varmagokul6/Quadcopter-With-Autonomous-Payload/SolidWorks_Drawings.pdf

B | B

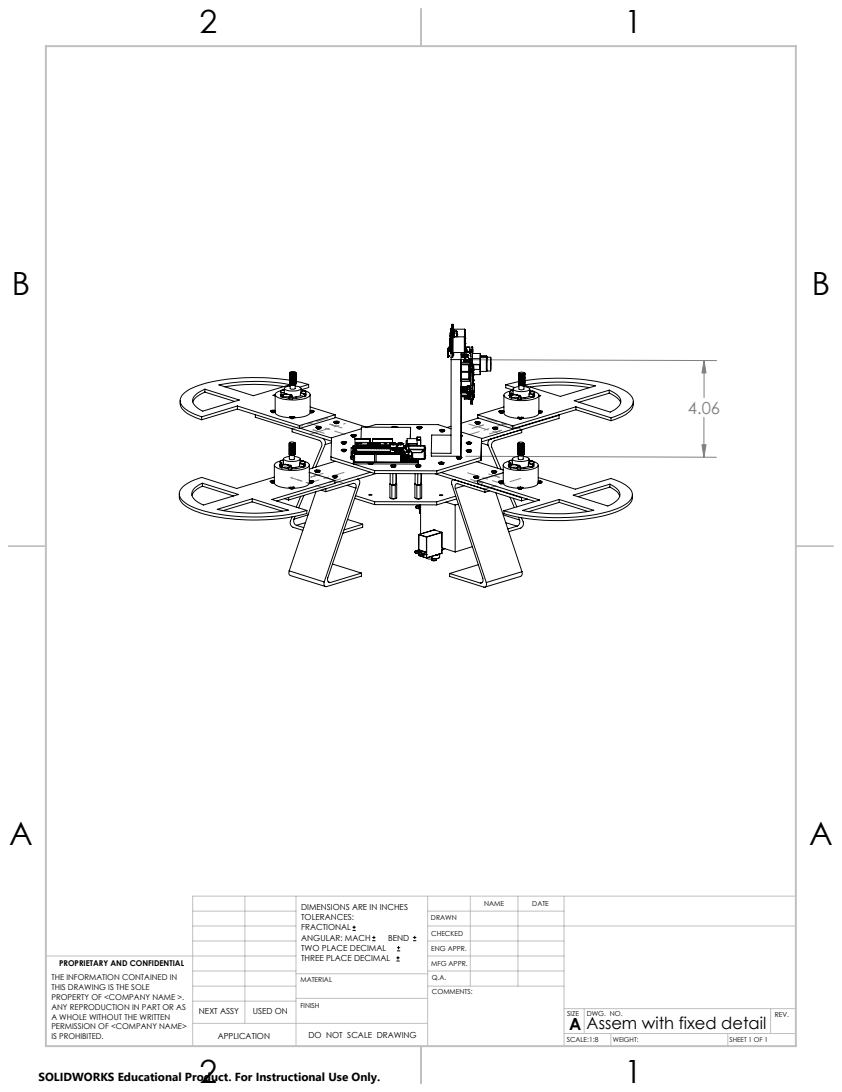
[picture p15: page 1]
COMMENTS:

TOLERANCES: FRACTIONAL ANGULAR: MACH BEND TWO PLACE DECIMAL THREE PLACE DECIMAL | | NAME | DATE DIMENSIONS ARE IN INCHES

DRAWN
CHECKED
ENG APPR.

PROPRIETARY AND CONFIDENTIAL THE INFORMATION CONTAINED IN THIS DRAWING IS THE SOLE PROPERTY OF <COMPANY NAME >. ANY REPRODUCTION IN PART OR AS A WHOLE WITHOUT THE WRITTEN PERMISSION OF <COMPANY NAME> IS PROHIBITED. | | | MFG APPR.

MATERIAL | Q.A.

NEXT ASSY | USED ON | FINISH

SIZE A | DWG. NO. Assem with fixed detail | REV.

APPLICATION | | DO NOT SCALE DRAWING

SCALE:1:8 | WEIGHT: | SHEET 1 OF 1

SOLIDWORKS Educational Product. For Instructional Use Only.

B | B

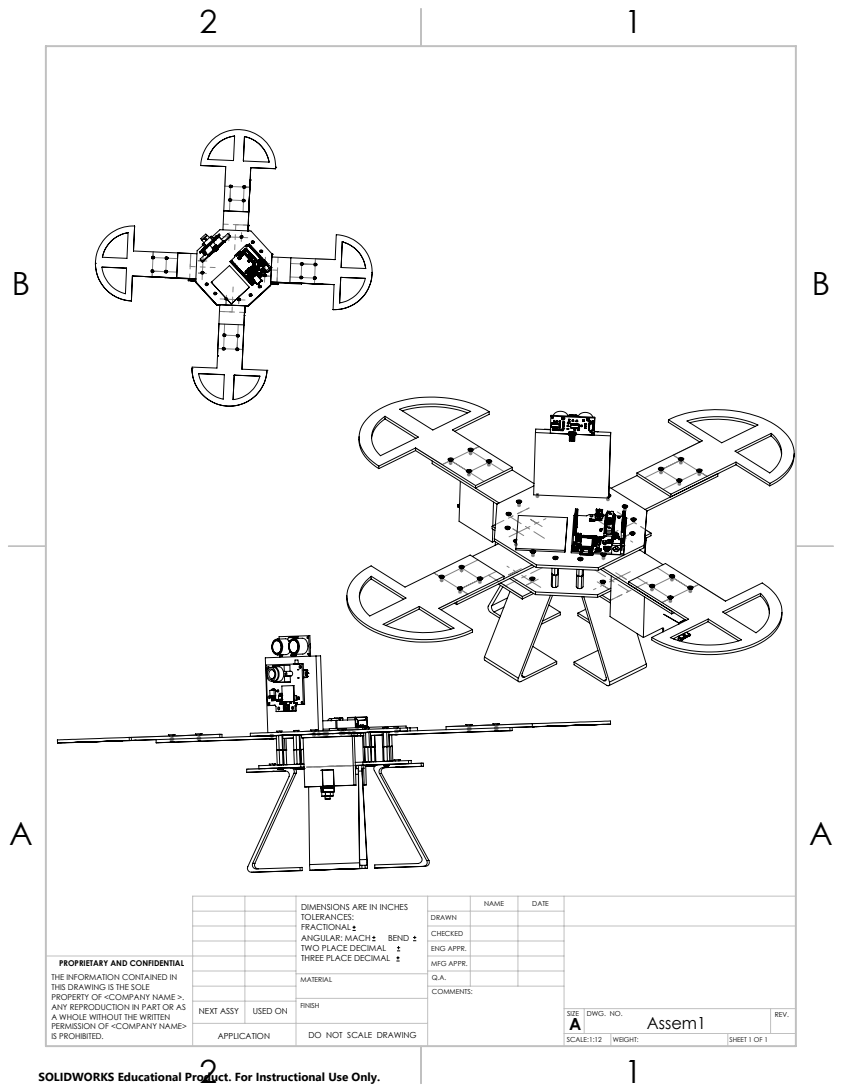
[picture p16: page 2]
Assem1; COMMENTS:

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

DRAWN
CHECKED
ENG APPR.

PROPRIETARY AND CONFIDENTIAL THE INFORMATION CONTAINED IN THIS DRAWING IS THE SOLE PROPERTY OF <COMPANY NAME >. | | | MFG APPR.

MATERIAL | Q.A.

B | B

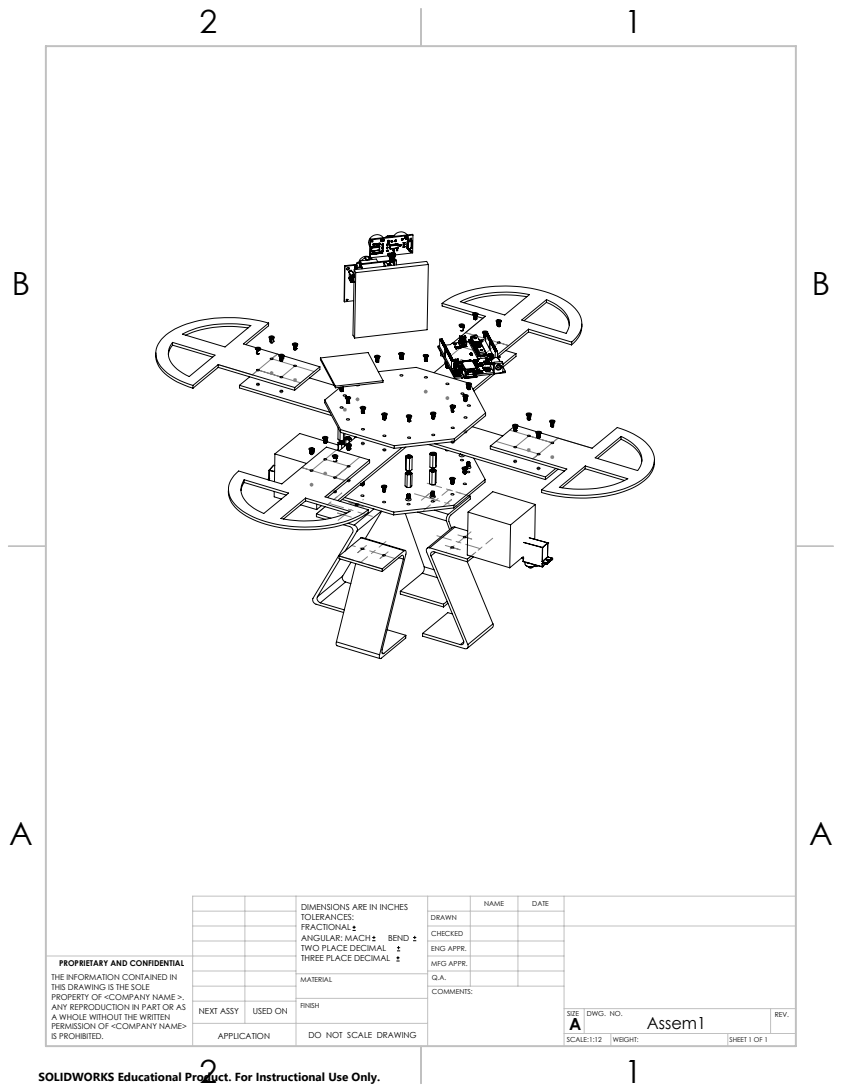
[picture p17: page 3]
Assem1; COMMENTS:

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

DRAWN
CHECKED
ENG APPR.

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

MATERIAL | Q.A.

2.49
B | B

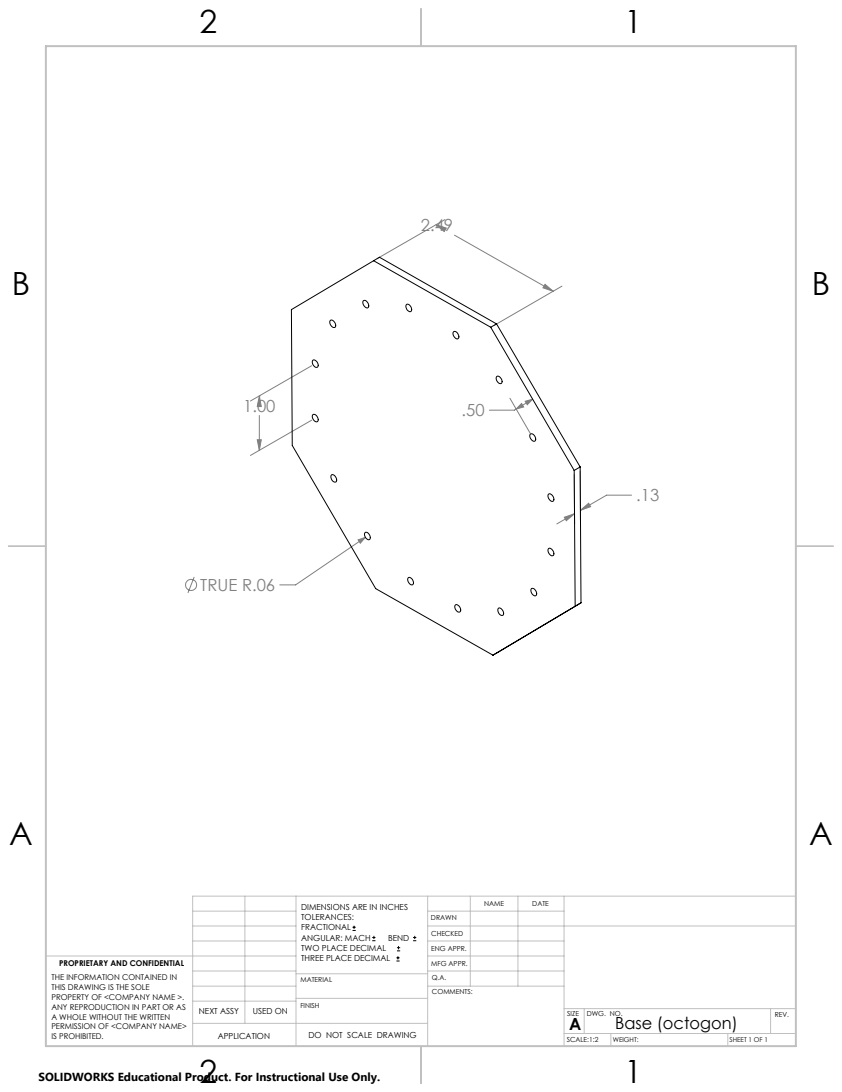
[picture p18: page 4]
TRUE R.06; Base (octogon); COMMENTS:

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

DRAWN
CHECKED
ENG APPR.

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

MATERIAL | Q.A.

B | B

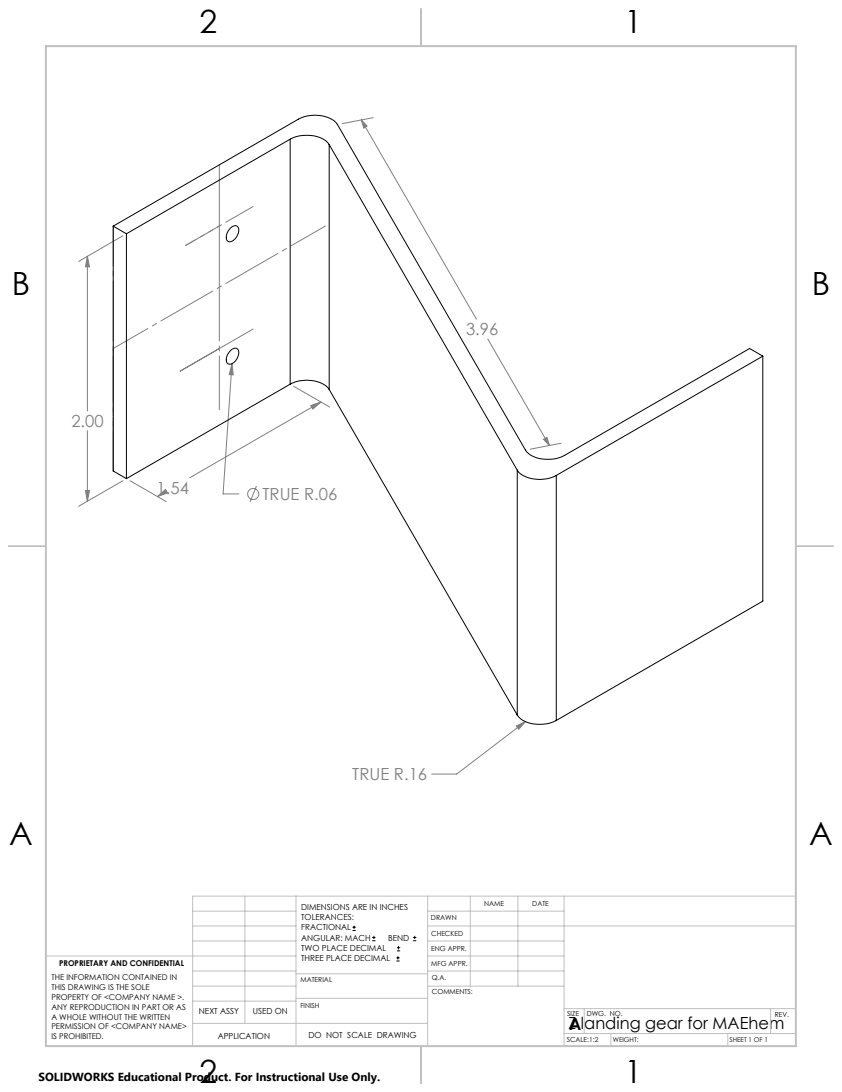
[picture p19: page 5]
TRUE R.06; TRUE R.16; COMMENTS:

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

DRAWN
CHECKED
ENG APPR.

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

MATERIAL | Q.A.

Z landing gear for MAEhem

B | B

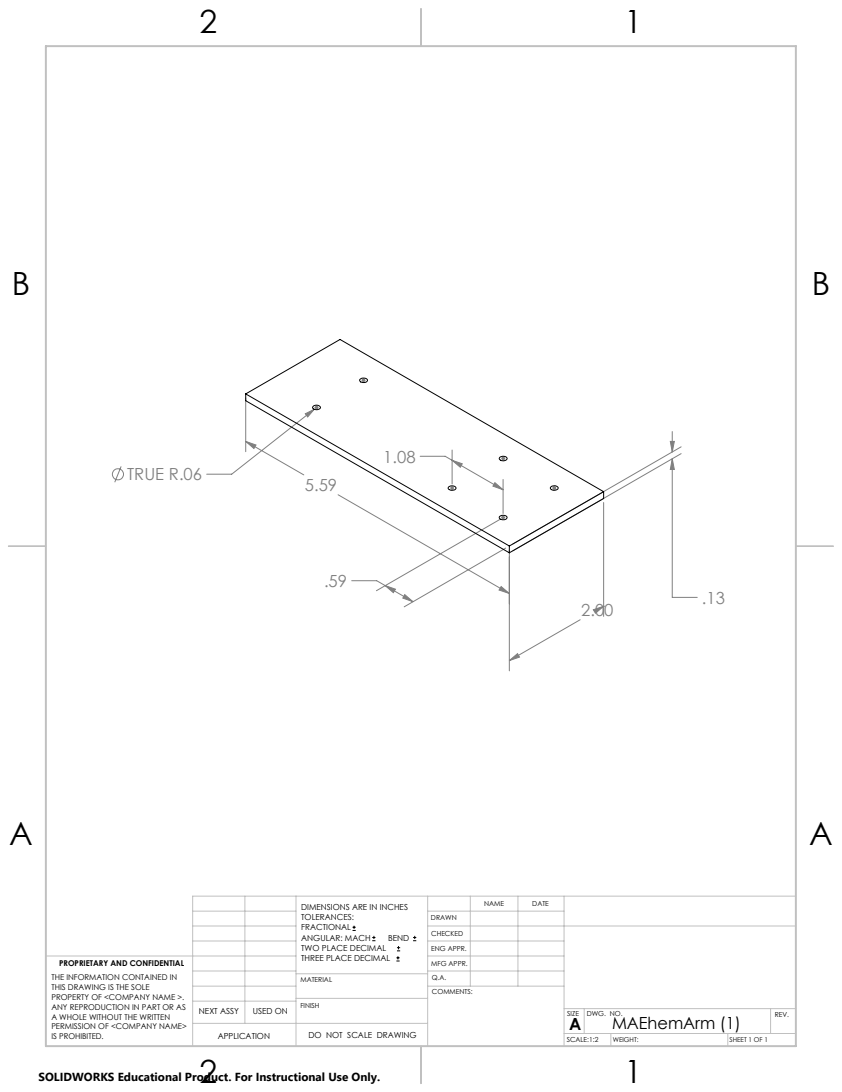
[picture p20: page 6]
TRUE R.06; MAEhemArm (1); COMMENTS:

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

DRAWN
CHECKED
ENG APPR.

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

MATERIAL | Q.A.

B | B

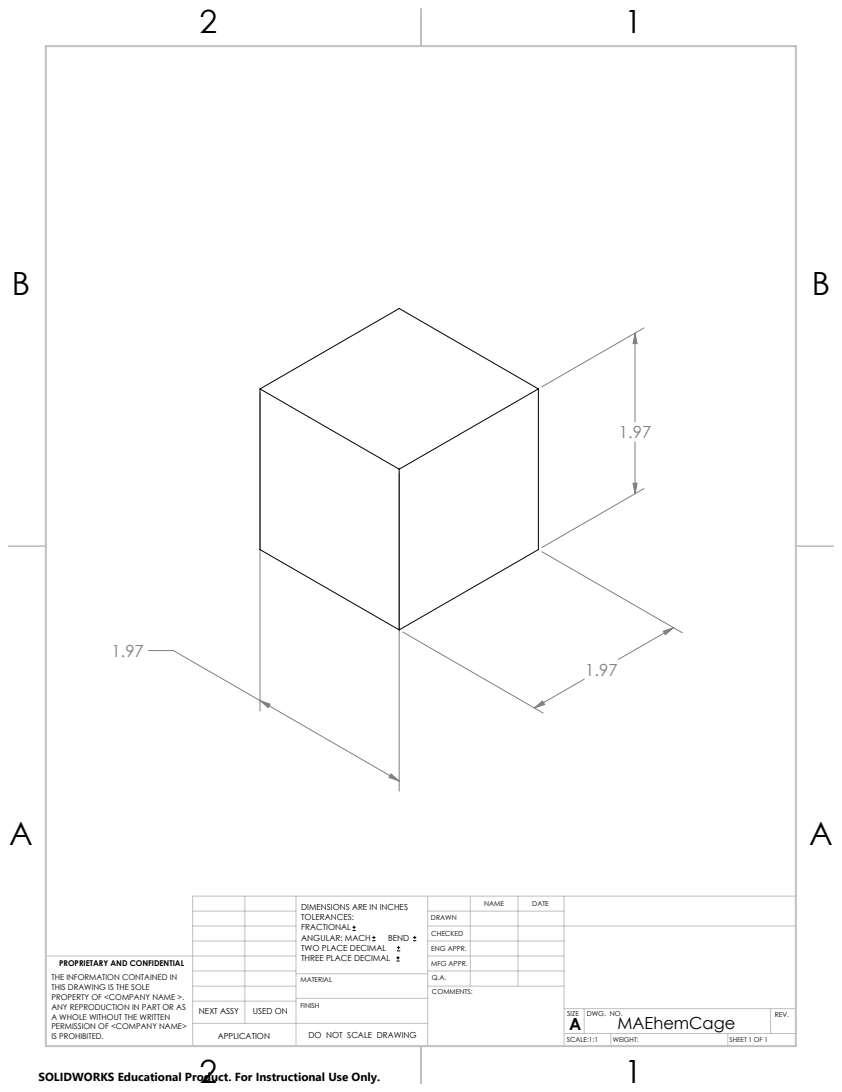
[picture p21: page 7]
MAEhemCage; COMMENTS:

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

DRAWN
CHECKED
ENG APPR.

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

MATERIAL | Q.A.

B | B

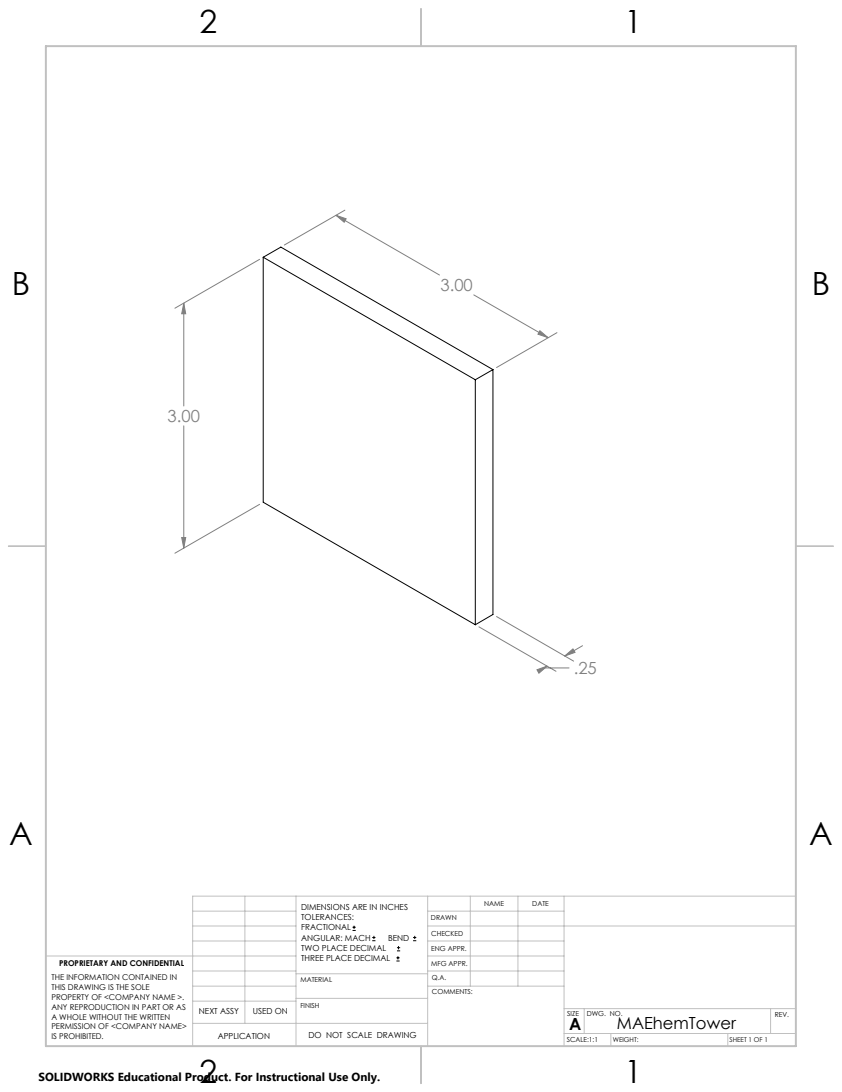
[picture p22: page 8]
MAEhemTower; COMMENTS:

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

DRAWN
CHECKED
ENG APPR.

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

MATERIAL | Q.A.

B | B

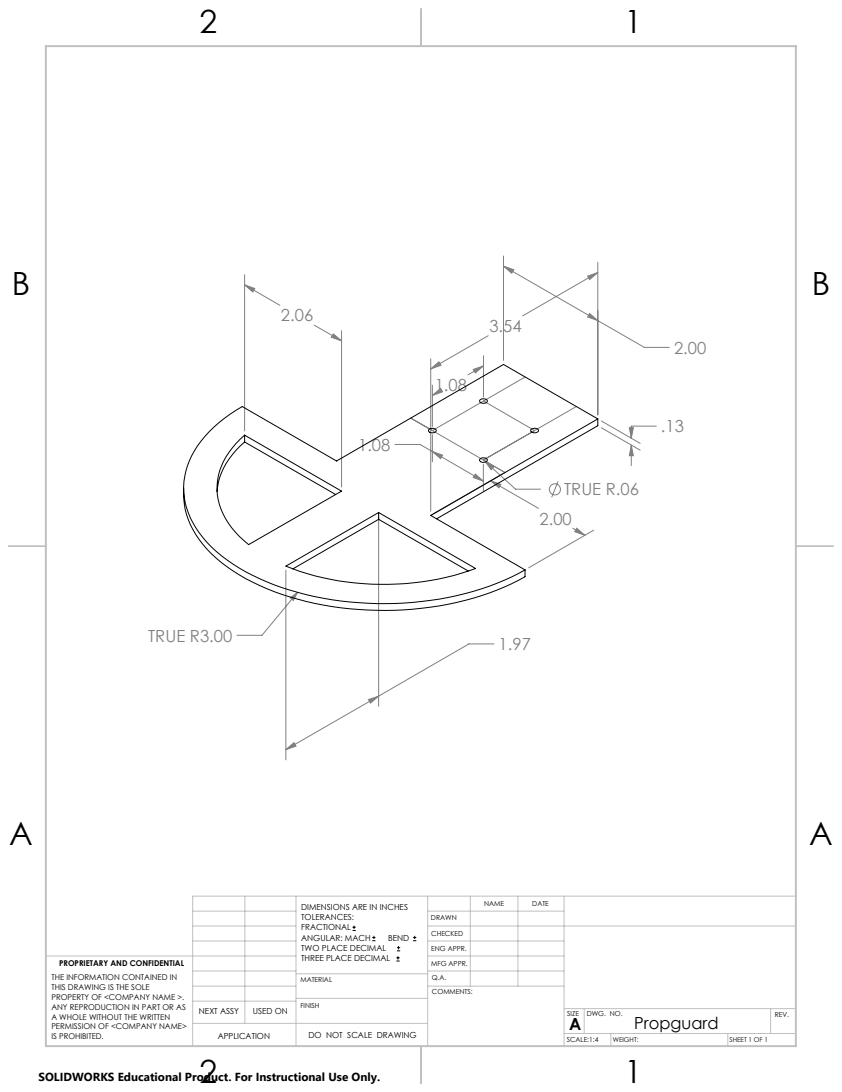
[picture p23: page 9]
1.97 TRUE R3.00; TRUE R.06; Propguard; COMMENTS:

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

DRAWN
CHECKED
ENG APPR.

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

MATERIAL | Q.A.
